cranberry314/Fledge/firmware/SNIFFING.md

# Sniffing the remote

What the remote sends for each control, found one control at a time.
Read this before a sniffing session and follow the steps exactly: the
point is that every packet can be matched to one known stick position or
button press, without guessing afterwards.

## What we already know

From the bench scans (`SETUP.md` step 5) and the drone's manual:

- **Pairing.** Drone on first: its light blinks slowly. Then remote on:
  its light blinks. Push the left stick full forward (the remote beeps),
  then full back (it beeps again). When both lights stay on, they are
  paired. While the remote is waiting to pair, it transmits on nRF24
  channels 16-17 (2416-2417 MHz) and keeps doing so. Once paired, the
  energy scan can no longer see it.
- **The left stick springs back to the middle** in both directions
  (checked on the real remote). Let go of it and the drone holds its
  height ("Hover" in the manual). So the left stick sets how fast to
  climb or sink, and holding it longer makes the drone go higher. That
  may explain why a short push gives "a little" and a long push "a lot".
  The hold test checks whether the remote's numbers change while a stick
  is held, or only the drone's response does.
- **The remote's radio is an XN297, or a copy of one, at 1 Mbps.** The
  nRF24 can read it. `Sniffer/` listened on channels 16-17 in every way
  it knows. With the remote off, nothing but noise. With the remote on
  (drone off), about 24 packets a second arrived on each channel, every
  one byte-for-byte the same, and only when listening for the XN297
  start pattern at 1 Mbps.
- **The pairing packet, decoded.** 24 bytes after the XN297 start
  pattern: a 5-byte address, a 16-byte payload, a 2-byte checksum, then
  one more byte that is always the same (not explained yet). Unscrambled
  with the XN297 scramble table, the address is `CC CC CC CC CC`, and the
  checksum matches (XN297 CRC-16, start value 0xB5D2, scrambled-mode
  xorout table), so the decoding is exact. The payload is `10`, then 5
  bytes that are probably this remote's own ID, then ten `00`s.
- **After pairing** (drone on, then remote on), the remote moves to
  channels **60, 63 and 65**, still at address `CC CC CC CC CC`, sending
  a 16-byte payload that passes the checksum. It left channels 16-17
  within about 8 seconds of being switched on. At rest the payload is:
  `ID 3F 70 0A 80 80 80 80 00 00 40 3F 00 C0 ID ID`, where the three
  `ID` bytes match part of the ID in the pairing packet.
  - The energy scan could not see any of this because channels 56-68
    are busy with Wi-Fi here.
  - Weak packets 16 channels either side (44-49, 76-81) all fail the
    checksum: the nRF24 also hears strong signals 16 MHz away. They are
    not the drone talking back.
- **Timing** (protocol captures, 2026-10-11): while pairing, the remote
  alternates channels 16 and 17. Once paired it sends one packet about
  every 7.6 ms, on channels 63, 65, 65 and 60 in turn.
- **What each byte means** was worked out in the coach sessions and is in
  [Relay/DroneActions.md](Relay/DroneActions.md). That file is the answer
  key: to find the bytes yourself, run the sessions below first. The
  relay pairs and flies the drone with these results (tested 2026-10-14).
- The XN297 framing was cross-checked against the
  [DIY-Multiprotocol-TX-Module XN297 emulator](https://github.com/pascallanger/DIY-Multiprotocol-TX-Module).
- **Not a protocol Multiprotocol already knows.** Its only protocol that
  pairs on `CC CC CC CC CC` is MT99xx, whose pairing payload is 9 bytes
  starting with `20`. So this one gets decoded here, step by step.
- The manual is shared by several models (it mentions "WIFI control",
  which this drone has no hardware for) and has no FCC ID. If no sticker
  turns up (remote battery cover, drone battery bay, box), open the remote
  and photograph the chip next to its antenna: its part number says which
  radio family it is. The sniffer's first run answers the same question:
  if it reads packets at all, the chip is nRF24-compatible.

## Names

Always use these names, never "throttle", "pitch" or "the flip thing".

**Sticks.** "Left stick" and "right stick". Directions as seen by the
person holding the remote: **forward** (away from you), **back** (towards
you), **left**, **right**.

| Stick | Forward | Back | Left | Right |
|---|---|---|---|---|
| Left  | climb | sink | turn left | turn right |
| Right | fly forward | fly back | slide left | slide right |

**Positions.** Only ones that can be repeated by hand:

- **neutral**: hands off; the spring puts it there.
- **full**: pushed until it stops.
- **half**: to a pencil mark on the remote, drawn once and reused.

**Buttons.** By what you see, holding the remote normally: two on the
top edge, then below the sticks a row of an oval button, two small round
buttons and the power switch. (The manual numbers them in a diagram; the
numbers aren't on the remote, so they are only here for looking things
up in the manual.)

| Name | Manual # | Manual's name | Press | Hold ~3 s |
|---|---|---|---|---|
| **top-left button** | 1 | High/low speed | switch between slow and fast | ? |
| **top-right button** 🤸 | 2 | One-key flips & rolls 360° | arm a flip (the remote beeps); then push the right stick full in a direction and the drone flips that way | ? |
| **oval button** | 5 | One-key ascend/landing | take off; press again to land | trim (see below) |
| **left small round button** | 6 | Light switch | ? (manual unclear) | lights off? |
| **right small round button** 🛑 | 7 | Emergency stop / correction | **stop motors** (manual) | level calibration (remote beeps, drone lights flicker ~3 s) |
| **power switch** | 9 | Power switch | on / off | |

What each one sends to the drone is left out of this file on purpose, so
it can be worked out fresh with the steps below. The answers are in
[Relay/DroneActions.md](Relay/DroneActions.md): open it afterwards.

**Trims** ("fine-tuning"): the manual says to long-press the oval button
"and then" push the right stick in the direction to correct. It doesn't
say whether the oval button stays held while pushing, or whether a long
press enters a trim mode. The trim steps try both, and the packets say
which works.
Count each push as one click.

**Rest** means: both sticks neutral, hands off the buttons, trims
untouched, speed as the remote starts up. Every test starts from rest and
returns to it.

## Before each session

1. **Props off**, said out loud. The oval button and the left stick both
   spin the motors once paired.
2. Drone battery charged, 3 fresh AAAs in the remote.
3. RadioCheck passes (`SETUP.md` step 4).
4. The ESP32 running `Sniffer` plugged in, with its channels set to 65
   to 65 for a control session. The coach records it by itself.

The motors will probably spin during some steps (left stick forward,
the oval button). With props off that is expected: carry on. The right
small round button, pressed once, stops them at any time.

## Running a session

`coach/coach.py` shows each step and waits for Enter. Then you have 15
seconds to do it, counted down. At the same time it records everything
the sniffer hears, and after each step it says whether the remote's
signal changed:

    Right stick ⬆️ full forward  ⏱ 15 seconds
    Press Enter to start.
    Go!
    15 14 ... 1 (one per line)
    ✅ The remote's signal changed      (or ❌ No change seen)
    Let go ✋
    3 2 1

Run it in a terminal, in `firmware/coach/`, with one of the step lists:

    python3 coach.py pairing.txt      # just the binding sequence, 4 steps
    python3 coach.py sticks.txt       # every stick test, 26 steps
    python3 coach.py buttons.txt      # every button test, 20 steps
    python3 coach.py flips.txt        # a flip in each direction, 12 steps

Before step 1 it listens for 5 seconds and says whether it can hear the
remote; if the sniffer isn't plugged in it doesn't start. Add `--say` to
hear each line read aloud too, `--no-sniffer` to run the countdown
alone, or `--pseudo` for a practice run: the same prompts, no checks, a
👍 after every step, and logs named `...-pseudo` so they are never
mistaken for real data.

The step lists start by switching on the drone and the remote and
pairing them, so start with both off. Press **r** if a step went wrong,
or showed ❌: it is marked bad in the log and done again. Press **q** to
stop.

"Changed" means what the remote mostly sent during the step differs from
the 2 seconds before Go!, or something new arrived at least 3 times (a
quick button press). Only packets with a correct checksum count; damaged
copies can repeat and would look like a change. The coach doesn't know
which byte means what; that's for the paper table afterwards.

Two logs go in `firmware/captures/`, which git ignores: the steps (.csv,
with a remote_changed column) and everything the sniffer printed
(-sniffer.log), both timed by the Mac's clock.

The steps are in the `.txt` files in `coach/`: one per line, what to
do. A line can start with a number of seconds if that step needs a
different time. Change them there, not here. Each list starts with a
rest, the baseline: a number that changes when nobody touches anything
is probably a counter or checksum, not a control. Then:

- **`sticks.txt`**: each direction full (which number moves, and its
  two ends), half to a pencil mark (is the scale a straight line?), a
  slow clockwise circle and slow sweeps for each stick (every position:
  about 30 get recorded a second), then a long hold and a quick tap
  (does the remote's number grow while a stick is held, or only the
  drone's response?).
- **`buttons.txt`**: each button on its own, the trims (both ways the
  manual might mean, each undone), and last the oval button and the
  right small round button, because they start and stop the motors.
- **`flips.txt`**: a plain push to compare with, then a flip in each
  direction, then the top-right button on its own.

## Recording the binding and hop channels

The Sniffer sketch currently starts in focused pairing-capture mode. It
only listens: it alternates between channels 16 and 17, spending 10 ms on
each, and prints received packets in batches. It empties the radio's RX
FIFO at each channel change so queued packets are not attributed to the
wrong channel. Each `PKT` line has the receive time in microseconds, the
channel, and the first 23 packet bytes. A `DROPPED` line means its buffer
filled; repeat that capture. To return to the normal single-channel
Sniffer, set `CAPTURE_PROTOCOL` to `false` and upload again.

For a focused comparison, record one run with the remote on and the drone
off, then another with the drone in pairing mode and the remote on. Start
each log before switching on the remote, note whether the drone's lights
stop blinking or the remote beeps, and stop the log after switching both
off. Use a new log filename for every run.

With the props off, start from drone and remote both off. In
`firmware/coach/`, run `python3 coach.py buttons.txt` to capture binding
and button traffic, then `python3 coach.py sticks.txt` for stick traffic.
The coach saves its raw sniffer log in `firmware/captures/`, which is
ignored by git. Its initial "not hearing" warning is expected before the
remote is on and paired. Do not open the Serial Monitor at the same time;
the coach reads the ESP32 serial port itself.

These logs include the remote's radio ID. Keep them in `captures/` and
do not commit or share them. After recording, set `CAPTURE_PROTOCOL`
back to `false` to return to the normal Sniffer.

## Afterwards

For each step, write the result in a table on paper: which byte changed,
its value at rest, and its value in the step.
