cranberry314/Fledge/firmware/SETUP.md

# Setting up the Arduino tools and the radio

From a new Mac to an ESP32 and nRF24L01+ radio that work: install the
Arduino software, check each board, wire the radio, check it. Steps 1-2
are all the relay needs today; steps 3-5 are for the radio.

## 1. Install the Arduino software

    brew install --cask arduino-ide     # the app, with Serial Monitor and Plotter
    brew install arduino-cli            # the same thing from the command line

Then add ESP32 support and the nRF24 library (the app shares these):

    arduino-cli config add board_manager.additional_urls \
      https://espressif.github.io/arduino-esp32/package_esp32_index.json
    arduino-cli core update-index
    arduino-cli core install esp32:esp32
    arduino-cli lib install RF24

Board setting in the app: **ESP32 Dev Module**.

**Apple-chip Macs:** Arduino's `ctags` helper is Intel-only, so compiling
fails with "bad CPU type in executable" until Rosetta is installed:

    softwareupdate --install-rosetta --agree-to-license

## 2. Check each ESP32 talks to the Mac

Plug it in with a USB-C cable that carries data (charge-only cables light
the board but the Mac never sees it). A new port such as
`/dev/cu.usbserial-0001` should appear:

    ls /dev/cu.*

## 3. Wire the nRF24L01+ to the ESP32

Follow **[Wiring the radio](../README.md#wiring-the-radio)** in the main README: the drawing, the color of every wire,
and the checks to do before plugging in USB.

## 4. Check the radio with RadioCheck

`firmware/RadioCheck/RadioCheck.ino` checks the wiring, then scans every
channel for radio activity. Run it at the start of each bench session: it
answers "is the radio alive?" before anything harder goes wrong.

In the Arduino IDE: open `RadioCheck.ino`, pick **ESP32 Dev Module** and the
`usbserial` port, press Upload, then open the Serial Monitor at **115200**.
Or from the command line, in `firmware/`:

    arduino-cli compile --fqbn esp32:esp32:esp32 RadioCheck
    arduino-cli upload --fqbn esp32:esp32:esp32 -p /dev/cu.usbserial-0001 RadioCheck
    arduino-cli monitor -p /dev/cu.usbserial-0001 --config baudrate=115200

It repeats forever: a wiring report, then six scan lines about 8 seconds
apart, so a full round takes about a minute. If you open the monitor late,
wait for the next `=== RadioCheck ===`.

**Wiring is good when** it says `isChipConnected(): yes`, every read-back
line says `ok`, and `SPI read-back: ALL OK`. `NO`, `MISMATCH` or read-backs
of 0 or 255 mean a loose or swapped wire (check MISO, SCK, MOSI, CSN) or no
3.3 V power.

**The receiver is good when** the scan shows known signals. Each scan line
has one character per channel, 0 on the left to 125 on the right (channel N
is 2400 + N MHz). `-` means nothing was heard; `1` to `f` mean it was heard
a little to a lot. Bluetooth always advertises on channels 2, 26 and 80,
and a Wi-Fi network shows as a block about 20 channels wide. A scan of all
`-` means the receiver is not working, even if the wiring check passed.

A few bytes of junk when the monitor first connects are normal.

The scan only hears that a channel is busy. It does not read packets.

## 5. Find the remote's channels

1. Remote **off**: save a minute of scan lines. This is the baseline. On
   the bench so far: Bluetooth at 2, 26 and 80, and a Wi-Fi block at about
   56-68.
2. Remote **on**: save a minute of scan lines, including the first few
   seconds after switching it on. Many toy remotes send "bind" packets on
   one channel at power-on, then hop across several.
3. Channels busy only in the second scan are the remote's. Write them down.

Busy channels do not prove the remote's chip is nRF24-compatible: any
2.4 GHz radio shows up here. Reading its packets is the next step.

**Result (drone off, remote on, sticks untouched):** channels **16 and 17**
(2416-2417 MHz), with a little spill onto 14-15. They were quiet in 68
scan lines before, busy in 11-13 of the 14 lines while the remote was on,
and quiet again once it was switched off. Channels 41, 46, 47 and 71 got
a few faint hits while it was on: possibly hopping, possibly noise.
With the drone off, the remote is probably still trying to pair, so the
channels may change once the drone is on.

**Props off** for every bench test with the drone switched on: a paired
drone spins up as soon as the throttle moves.

**Result (drone on, then remote on):** the drone alone showed nothing
above the baseline. About 10 seconds after the remote came on, 16-17 went
quiet and stayed quiet, apart from one burst across about 11 scattered
channels. After that the remote looked no different from the remote being
off. It had paired: the motors ran when the throttle went up. So the
remote was transmitting the whole time, and this scan could not see it.
The sniffer later showed why: once paired it uses channels 60-66, right
under the Wi-Fi block. Reading the packets is in [SNIFFING.md](SNIFFING.md).
