cranberry314/Fledge/(commit log)

2026-09-26 Choose Arduino C++ for the ESP32 relay firmware
    The relay only forwards bytes from BLE to the nRF24, and existing toy-drone
    protocol code is C++. Flight settings stay in Tuning.swift. A separate
    MicroPython board is a beginner playground, kept out of firmware/.
2026-09-28 Add bench setup guide and RadioCheck for the nRF24
    SETUP.md walks from a new Mac to a wired ESP32 + nRF24L01+. RadioCheck
    verifies the SPI wiring by writing radio settings and reading them back,
    then scans all 126 channels for activity. Next step: compare scans with
    the drone's remote off and on to find its channels.
2026-09-28 Record the remote's channels from the first scan
    With the drone off, the remote transmits on nRF24 channels 16-17
    (2416-2417 MHz): quiet before it was switched on, busy while on, quiet
    again after it was switched off.
2026-09-28 Note that the remote was paired during the drone-on scan
    The motors responded to the throttle, so the remote was transmitting
    while the energy scan showed nothing. Also add a props-off reminder.
2026-09-28 Add a sniffing plan: control names and exact test steps
    SNIFFING.md names every stick direction and button (by the number in the
    drone's manual), defines the only stick positions used (neutral, full,
    half), and lists the pairing and control tests in order, one change at a
    time, so every captured packet can be matched to a known input.
2026-09-28 Add the sniffer, and record that the remote is an XN297 at 1 Mbps
    Sniffer listens on channels 16-17 at every data rate, for both the XN297
    start pattern and plain nRF24 packets, and reports packets that repeat
    byte for byte. With the remote off it hears only noise; with it on it
    hears one 24-byte pairing packet about 24 times a second, only as XN297
    at 1 Mbps. Unscrambled, the packet has address CC CC CC CC CC and a
    16-byte payload, and its CRC checks out. No Multiprotocol protocol
    matches it.
    [Sniffer.ino]
2026-09-28 Sniffer sweeps all channels; record the paired remote's packets
    The sniffer now listens on every channel, only as XN297 at 1 Mbps unless
    told otherwise, and prints only channels where it heard something. A
    pairing session run with coach.py showed the paired remote on channels
    60, 63 and 65, still at address CC CC CC CC CC, with a 16-byte payload
    that passes the checksum: four bytes at 0x80 (probably the sticks,
    centred) and a byte that looks like the next hop channel. The energy scan
    missed this because Wi-Fi covers those channels; SETUP.md said it was
    hopping too fast, which was wrong. pairing.txt now ends with 2 minutes at
    rest so the paired packets get recorded too.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
    [Sniffer.ino]
2026-09-28 Shorter sessions: coach --quick, 3 s stick holds, sniffer on one channel
    coach.py --quick uses a 2 s get-ready countdown and 1 s between steps;
    without it the countdowns stay long. Stick holds in controls.txt drop
    to 3 s (the 10 s hold tests stay), and pairing.txt's final rest to 30 s,
    since the sniffer no longer has to sweep every channel: for a control
    session it listens on channel 65 only. It now prints its settings every
    30 s rather than once per round, which with one channel would flood the
    output.
    [Sniffer.ino]
2026-09-28 coach.py records the sniffer itself and says if each input registered
    coach.py now opens the Sniffer ESP32's serial port (sniffer_link.py, no
    extra installs), logs every line it prints with the Mac's time, and
    refuses to start if the sniffer isn't plugged in. Before step 1 it
    checks it can hear the remote; after each step it says whether the
    remote's signal changed (a packet seen 3+ times during the step and
    never in the countdown before it), and logs that in a new column.
    --no-sniffer runs the countdown alone. The sniffer no longer prints a
    ROUND line when it listens on a single channel.
    Tested with a fake serial port replaying a real recording, with real and
    simulated packets for the chan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
    [Sniffer.ino]
2026-09-28 coach: fix false ❌ and ✅ in the change check
    Two faults found by replaying the first full control session:
    - A stick moved on the "1" of the countdown put a few moved packets in
    the "before" window, so the whole step looked unchanged (❌ on steps
    where the stick clearly moved). The check now also compares what the
    remote mostly sent before and during the step, using only the bytes
    that carry the controls (7-17), so hopping doesn't count as a change.
    - Damaged copies of a real packet can repeat, which made ✅ out of
    nothing. sniffer_link.py now keeps only packets whose checksum is
    right: CRC-16 CCITT over the first 21 bytes, XORed with 0x5B63, a
    constant measured from our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
2026-09-28 Name buttons by what's on the remote, not the manual's numbers
    The manual's diagram numbers aren't printed on the remote, so "button 6"
    meant nothing at the remote. Steps and SNIFFING.md now say top-left,
    top-right, oval, left small round, right small round and power switch;
    the manual numbers stay in one column of SNIFFING.md's table only for
    looking things up in the manual.
2026-09-28 Add buttons.txt: the button steps on their own, one press per step
2026-09-28 Steps of 10 seconds become 8
    Asked for because the remote seemed to stop sending after about 10 s.
    The first control session doesn't show that: about 30 good packets a
    second right through every 10 and 15 s step, and no gap longer than
    0.27 s. The one drop was fewer packets on channel 65 while the right
    stick was pushed after the top-right button (step 21), not a stop.
2026-09-28 coach --quick waits for Enter; step lists start by switching on
    With --quick, each step is shown and starts when Enter is pressed, with
    no countdown; without it the countdown is unchanged. controls.txt and
    buttons.txt now begin with switching on the drone and remote and
    pairing them. Steps starting with "Switch" get no ✅/❌ (there is
    nothing to compare with), only "Hearing the remote" once it is on.
    The change check compares with the 2 seconds before Go!.
2026-09-28 SNIFFING.md: describe the current ✅ rule, rewrap
2026-09-28 coach --pseudo: a practice run with no checks
    Same prompts and countdowns, but nothing is checked: every step ends
    with "👍 Well done!" rather than ✅/❌. The sniffer is still recorded if
    it is plugged in, into logs named ...-pseudo so they are never mistaken
    for real data; if it isn't plugged in, the run goes ahead anyway.
2026-09-28 Map every stick position with slow circles and sweeps
    The single diagonal step becomes, for each stick, a slow clockwise circle
    at the edge and slow sweeps forward-back and left-right, recording about
    30 positions a second; sticks.txt runs just these. The change check also
    counts a step as changed when at least 30% of its packets are new, since
    in a sweep no single position repeats; replayed on both control
    sessions, no rest or switch step turns into a change. Step durations now
    show as "⏱ N seconds" so "hold for 3 seconds" isn't followed by
    "for 5 seconds".
2026-09-28 Condense the step lists and bring the docs up to date
    controls.txt repeated most of the other step lists, so its steps now
    live in three lists only: sticks.txt (every stick test), buttons.txt
    (every button test) and flips.txt. pairing.txt is removed: with the
    sniffer on channel 65 it can't hear pairing, and every list already
    starts by pairing. SNIFFING.md drops early guesses that are now
    settled, and the READMEs and CLAUDE.md describe the bench tools and the
    gitignored captures folder.
2026-09-28 Add a bubble level and a compass to the app
    Motion.swift reads the phone's motion sensors: tilt from gravity, and
    heading from the magnetic-north reference frame, plus how far the phone
    has turned since "Start here", which is what will later turn the drone.
    LevelView floats a bubble to the high side and turns it green inside
    tiltDeadZone; CompassView turns a dial so N points north. Three colours
    join Tuning.swift. project.yml adds a motion-sensor usage description.
    Built for the simulator and the phone, installed and launched; the
    heading's direction still needs checking against the Compass app.
2026-09-28 Make the app landscape, charging port on the right
    The app is held sideways like a game controller. It supports one way
    round only, so the motion code can map the phone's own axes to the
    screen: tilt right uses the phone's bottom-edge axis, tilt forward its
    right-edge axis, and the heading is that of the phone's right edge, the
    screen's far edge. The level, compass and flip button sit in a row.
2026-09-28 App icon: a drone seen from above
    Four propellers in round guards and an orange body with a white light at
    the front, on a sky-blue background. 1024x1024, no transparency.
2026-09-29 Turning ring, up/down slider and the Bluetooth link to the relay
    - TurnRing.swift: touch the ring (90-degree steps) and the drone turns to
    face that way; turning the phone adds small turns. The drone has no
    compass, so the ring's marker is a guess from droneTurnSpeed.
    - UpSlider.swift: drag up to climb, down to sink; springs back to the
    middle (hold height) when let go. Lifting or lowering the phone more
    than phoneLiftDeadZone also climbs or sinks gently, from the
    barometer, capped at phoneLiftMax.
    - "Start here" is now "Zero Level", and the bubble level reads from it.
    - Bluetooth.swift: finds the relay and sends the controls 20 times a
    second, in the 5-byte format described in P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
2026-09-29 Relay: the Bluetooth side, receiving the phone's controls
    firmware/Relay receives the controls messages from PROTOCOL.md and
    prints them on the Serial Monitor; nothing goes to the drone. The blue
    LED is on while the phone is connected. If the phone disconnects, or no
    message arrives for 500 ms, every value goes back to 0, and the relay
    says how long any gap lasted.
    Checked on the bench with the phone app: all four controls arrive across
    their range, and closing the app zeroes everything.
2026-09-29 Fly/Stop switch, motors off, and the remote's other buttons
    The app starts on Stop, which sends "stay still" whatever the phone is
    doing; Fly zeroes the level and starts flying. Along the top: take
    off/land, lights, slow/fast, level calibration (only while stopped),
    the relay's status and a red Motors off (the emergency stop), which also
    goes back to Stop. Flip works like the remote: press it, then tip the
    phone the way to flip; the drone then stays still until the phone is
    level again.
    PROTOCOL.md version 2: 8 bytes, adding switches (speed, lights) and a
    one-off command with a count, so a lost message never loses a command.
    The relay and the Mac stand-in read version 2.
    Also: Zero Level r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
    [Relay.ino]
2026-09-29 Wiring diagram, wire colours and the parts list
    firmware/wiring.svg is the bench wiring drawing (ESP32 on a half-size
    breadboard, nRF24L01+ on seven jumpers, 10 uF capacitor), shown in
    SETUP.md step 3 with the colour of every wire and the safety checks to
    do before plugging in USB. This exact layout was built and worked first
    time, so the colours are part of the instructions.
    README: the parts by make and model, and the relay's current state.
2026-09-29 Flip in one tap
    The flip button now flips at once, the way the drone is flying (the way
    the phone is tipped most), or forward if the phone is level. The app
    says which way for 2 seconds, e.g. "flipping forward!". The two-step
    "press, then tip" version and its flipTip setting are gone.
    Builds; not yet tried on the phone.
2026-09-29 README: where to buy the parts, and why this ESP32 works with an iPhone
    The exact listings for the ESP32 boards, the nRF24L01+ radios and the
    breadboard kit. An iPhone app can only reach a homemade gadget over
    Bluetooth LE, which the ESP-WROOM-32 has (the ESP32-S2 doesn't). The
    boards' CP2102 USB chip needs no driver on a Mac.
2026-09-29 Docs: one path to follow, with the wiring in the main README
    The README now says where the project is at, then lists the build in
    order (buy, Arduino tools, relay, app, wiring), each step linking to the
    place that explains it. The wiring (drawing, every wire and its colour,
    build order, checks before USB) moved from SETUP.md into the README,
    where people look first. Building the app now covers signing
    (Local.xcconfig) and XcodeGen.
    firmware/README.md starts with the relay: how to put it on the board and
    what a working test looks like; the bench tools follow. SETUP.md says
    what it covers, links to the wiring, and drops the progress ticks from
    its headings.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
2026-10-05 Words under the picture buttons
    Take off or land, lights, slow/fast and calibrate now say what they do.
    Also clarify that the 📐 calibration is the drone's, not the phone's
    Zero Level, and mark maxThrottle as not working yet.
2026-10-11 Turn flicker fix, Pair button, sniffer capture mode and capture checker
    App:
    - Turn speed now starts from 0 at turnDeadZone instead of jumping to
    17%, so a small compass wobble no longer gives a sudden spin.
    - Heading is read from where the screen's far edge points seen from
    above, so tipping the phone no longer shifts it (it moved ~10 degrees
    at 30/20 degrees of tilt). Not yet checked on the phone against
    Apple's Compass.
    - A Pair button that sends command 8 (PROTOCOL.md).
    Sniffer (listen only):
    - Protocol capture mode on channels 16 and 17, emptying the receive
    buffer at each channel change so packets keep the right channel.
    - Puts its radio settings back and prints RADIO RESET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
2026-10-14 Relay pairs with the drone and holds the link at rest
    Pair sends the remote's pairing request on channels 16 and 17 and listens
    between requests. When the drone answers, the relay sends the hop list,
    then 20 seconds of controls at rest (sticks centred, no command) on the
    hop channels, then stops. The phone's sticks and commands are not sent yet.
    The radio ID stays in the gitignored LocalRadioId.h.
2026-10-14 Relay: compute both check bytes the way the remote does
    Byte 13 is the low byte of (byte 1 + bytes 4-12 + 2) and byte 3 holds
    the bits above it. The relay used to guess byte 3 from the sticks, which
    was wrong for some stick positions. Now matches every recorded packet.
2026-10-14 Drone action table: every control and its packet
    DronePackets.h as a table: each stick and button on the remote, what it
    does and which bytes it sets, plus every action written out as a whole
    packet.
2026-10-14 Relay: one job per file, controls from the phone or the Mac
    Split the relay into small files, listed at the top of Relay.ino:
    Controls.h (the PROTOCOL.md message), PhoneLink (Bluetooth),
    TerminalLink (the same message as a text line over USB), Remote.h (the
    pretend remote's sticks and buttons), DroneLink (pairing and hop timing),
    XN297 (the radio chip's framing) and DronePackets.h (byte meanings).
    The test schedules are gone: moves now come from the phone or the Mac.
    If the controls stop, the relay centres the sticks and holds the
    throttle down; it never presses take-off/land, which is a toggle. A
    sender that goes quiet starts its command count afresh.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
2026-10-14 Fly the drone from the Mac: flight plans and keyboard flying
    drone.py has the moves (take_off, turn_right(180), land ...) and sends
    the relay controls 20 times a second over USB. flight_plan.py is a list
    of moves to rearrange, fly_with_keys.py flies with the keyboard, and
    tuning.py holds the settings, one per line. Every run is logged.
    relay_link.py drops copies of relay lines that arrive faster than the
    cable can carry them: macOS repeats the newest line right after the
    first write to the port.
2026-10-14 Docs: the new relay, flying from the Mac, and what the controls do
    PROTOCOL.md gains the USB text form and the new failsafe. The READMEs
    describe the relay's files, pairing and fly/. SNIFFING.md's controls
    table says what is now confirmed (the oval also lands, how a flip works).
2026-10-14 Publish the byte table: the relay needs no private files
    The remote ID moves into DronePackets.h, so a fresh clone can pair with
    the drone. DroneActions.md and DronePackets.h are now public, as the
    answer key to the sniffing activity; SNIFFING.md stays spoiler-free and
    points to them. Its hop-timing note is corrected (63, 65, 65, 60).
2026-10-14 GUIDE.md: building Fledge with a kid, stage by stage
    The order to do everything in, what the grown-up and the kid each do,
    how to work with a young kid (rehearse first, predict-run-change, short
    sessions, process praise), plus a different drone, your own app,
    Windows or Linux, and what isn't finished. Linked from the README.
2026-10-14 GUIDE.md: the kid wires the breadboard
    The grown-up wires it first, exactly as drawn including the colours, as
    the rehearsal; then the kid wires it by matching each wire's colour to
    the picture. The grown-up still checks the power wires before USB.
2026-10-14 GUIDE.md: the grown-up does the radio's pins, the kid the breadboard
    The radio's pins are small and on the back of the board; everything on
    the breadboard is a colour-matching job the kid can do.
2026-10-14 GUIDE.md: the kid's wiring steps are ones the grown-up can check
    The grown-up does every wire that carries power or has a polarity (the
    red and black wires, the capacitor), the radio's pins, and tapes over
    the ESP32's 5 V VIN column. The kid does the five signal wires, one at a
    time, each checked before the next: a misplaced one can't damage
    anything.
2026-10-15 Relay: back and left pushes no longer send the flip signal
    The spin, forward and sideways bytes are not '80 minus' on the back/left
    side: the remote sends the amount alone there (00 up to 41 in slow mode,
    60 in fast), and 80 plus the amount forward/right. The relay sent 80
    minus, so a small back or left push came out as 7F, which is the
    drone's flip back/left, and medium pushes went past full. Found in
    flight; checked against the remote's recorded slow stick sweeps. The
    throttle really is 80 plus or minus, unchanged. DroneActions.md fixed
    to match.
2026-10-22 fly: always re-pair, report a missing radio, add calibrate()
    pair() used to skip pairing when the relay said it was linked, but the
    relay can't tell when the drone was switched off, so a power-cycled
    drone never got paired again. It now always pairs; a drone that is
    already on answers in about a second. If the relay replies "Can't pair:
    no radio", the script stops at once and says to press EN, instead of
    waiting 35 s and blaming the drone.
    calibrate() sends the relay's level-calibration command (on the ground
    only). Whether the drone reacts to it from the relay is not confirmed yet.
2026-10-22 fly: takeoff_rotate.py and forward_back.py; calibrate in the flight plan
    takeoff_rotate.py: take off, half a turn, land.
    forward_back.py: take off, forward 1.25 s, back 1.25 s, land.
    Both flown from the Mac through the relay and landed as planned.
    flight_plan.py now calibrates before taking off.
2026-10-29 Add Fledge Code: a kids' drone language in the browser
    A Python-like language for young programmers (take_off(), forward(1),
    rotate(90), repeat 4:) that runs in Chrome, Chromebooks included, with
    no install. Each program is flown on paper before take-off: the drone
    stays within 3 seconds of where it took off, 3 seconds above its hover,
    and a program lasts 45 seconds at most. Mistakes get friendly messages
    that point at the line.
    Programs play on screen in real time, and fly the real drone over
    Bluetooth through the relay, sending the same message as the iPhone
    app. Stop lands it; so does hiding the page. A command line flies one
    command at a time, and an Examples menu gives programs to chan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
2026-10-29 Sync Fledge Code and the Mac tools: calibrate() and down_power
    Fledge Code gets calibrate(), like drone.py: the relay's level
    calibration, on the ground only (a program that calibrates in the air
    stops before take-off). It takes calibrateTime seconds, as on the Mac.
    The Mac gets down_power, like the web page's downPower: the drone sinks
    much slower than it climbs, so down() and the down key now push harder
    than up. Seen flying from the web page: up for 0.5 s climbed about as
    far as down for 2 to 2.5 s.
2026-10-30 Add Chromebook setup: a guide and a setup script
    The PDF covers adding an adult account, turning on Linux, and sharing
    the ESP32 with Linux. setup.txt installs VS Code, arduino-cli, the ESP32
    tools and RF24, and clones the repo.
